lamfe/versaloon-git/(threads)

Thread 1 (2021-04-07):

vsgui compile fix and general questions

bm16ton, 2021-04-07:
to get vsgui to comple needed,

--- /media/maddocks/usb3tb/stm32-std-periph-drivers_porting-tools/versaloon-git/vsgui/hexeditor.pas	2021-04-07 08:28:23.160413990 -0400
+++ /media/maddocks/usb3tb/versaloon-newgui/vsgui/hexeditor.pas	2021-03-15 06:45:00.427950466 -0400
@@ -1048,7 +1048,7 @@
     end;

     try
-      if not FileExistsUtf8(SaveAsFileName) then
+      if not FileExists(SaveAsFileName) then
       begin
         HandleTmp := FileCreate(Utf8ToAnsi(SaveAsFileName));
         if HandleTmp = NULL then
@@ -1246,7 +1246,7 @@
   FillChar(DataBuff[1], DataByteSize, DefaultData);

   // open file and read
-  if FileExistsUtf8(FileName) then
+  if FileExists(FileName) then
   begin
     ext := LowerCase(ExtractFileExt(FileName));
     CurFileParserIndex := 0;

--- /media/maddocks/usb3tb/stm32-std-periph-drivers_porting-tools/versaloon-git/vsgui/texteditor.pas	2021-04-07 08:28:23.163747404 -0400
+++ /media/maddocks/usb3tb/versaloon-newgui/vsgui/texteditor.pas	2021-03-15 06:45:45.752659720 -0400
@@ -25,7 +25,7 @@
     { private declarations }
   public
     { public declarations }
-  end;
+  end;

 var
   FormTextEditor: TFormTextEditor;
@@ -53,7 +53,7 @@
   tmpStrList: TStringList;
   i: integer;
 begin
-  if not FileExistsUtf8(TextFileName) then
+  if not FileExists(TextFileName) then
   begin
     Beep;
     MessageDlg('Error', TextFileName + ' not exists.', mtError, [mbOK], 0);

--- /media/maddocks/usb3tb/stm32-std-periph-drivers_porting-tools/versaloon-git/vsgui/main.pas	2021-04-07 08:28:23.160413990 -0400
+++ /media/maddocks/usb3tb/versaloon-newgui/vsgui/main.pas	2021-03-15 06:49:50.942092130 -0400
@@ -1712,7 +1712,7 @@
       MessageDlg('Error', 'No File Defined.', mtError, [mbOK], 0);
       exit;
     end;
-    if not FileExistsUtf8(TargetFile[fileidx].filename) then
+    if not FileExists(TargetFile[fileidx].filename) then
     begin
       Beep();
       MessageDlg('Error', '"' + TargetFile[fileidx].filename + '" not exists.',
@@ -2087,8 +2087,8 @@
       (Sender as TDirectoryEdit).Directory + System.DirectorySeparator;
   end;

-  VSProg_Exists  := FileExistsUtf8(dedtVSProg.Directory + VSPROG_STR);
-  OpenOCD_Exists := FileExistsUtf8(dedtOpenOCD.Directory + OPENOCD_STR);
+  VSProg_Exists  := FileExists(dedtVSProg.Directory + VSPROG_STR);
+  OpenOCD_Exists := FileExists(dedtOpenOCD.Directory + OPENOCD_STR);
 end;

 procedure TFormMain.FormActivate(Sender: TObject);
@@ -2252,7 +2252,7 @@
 function TFormMain.VSProg_PrepareToRun(aApplicationName: string): boolean;
 begin
   Result := False;
-  if not FileExistsUtf8(aApplicationName) then
+  if not FileExists(aApplicationName) then
   begin
     exit;
   end;

Still not sure if it works havent tried much but many warnings during compile including missing .o's and deprecated things.

This software is incredible!! The more I look thru it the more I find! So it has usb mass storage option for drag n drop programming, and a scripting language that can be built in, both of which require a ton more storage then my f103s have! Have you trie them? What board did u use if so? I see stm32f4 discovery port but no f4 drivers, where early f4s peripherals compatible with f103 or something missing? I see you can compile the programmer into firmware (for drag and drop?) I assume swd uses same pins as jtag? I see the scripting docs and tried to use those commands (without scripting compiled in, again space) and using similiar but different syntax I forest gumped/guessed my way into some that didnt error out. all of my f4s use 25mhz hse and it doesnt look like the code supports that. Im very curious what this firmware with all bells and whistles turned on can do, for example the usbtoeverything does that control the peripherals on the programmer or target? And again how does this compile for f4? Lots of cod didnt go thru it all yet but dont see f4 clock settings (f4 at 72mhz maybe?) or peripheral drivers etc. Anyway super appreciate you keeping the old source and documenting it! seems like zoobab removed a ton of awesome stuff!

lamfe, 2022-03-08:
Hello, @bm16ton, thanks for fixing problems with `vsgui`. I have personally only used versaloon from the command line, so I didn't notice.
I have found this software by chance while looking for a way to upload program to a Silabs C8051 microcontroller that I bought.
A programmer with the C2 interface was needed to do that. (I found versaloon thanks to it being mentioned [here](http://dangerousprototypes.com/docs/Silicon_Labs_C8051F300_Quick_start))

I have only used the firmware on a Blue pill board with STM32F103 chip. I am sorry, but for other questions I don't know the answer, I have only used this software a few times, and have dug through the code just to fix compilation and things for my use. In the process I have felt the need to document the versaloon's usage better and in more detail, which would benefit not only me, but also others who would find a use for this piece of software.

I am glad you find versaloon interesting and contribute to improve it. I don't plan to dig in the code further or expand it, but at least I'll try to keep the compilation working with newer libraries/compilers.
