lamfe/versaloon-git/dongle/hardware/Connect/Connect.sch

## KiCad design dongle/hardware/Connect/Connect.sch (2012-09-20)

Schematic: Connect.sch

Parts:
P0, P1, P2, P3: CONN_10X2
