lamfe/versaloon-git/dongle/hardware/MiniRelease1/Versaloon.sch

## KiCad design dongle/hardware/MiniRelease1/Versaloon.sch (2012-01-09)

Schematic: Versaloon.sch

Parts:
C0, C1: 100uF
C10, C11, C12, C13: 100nF
C14: 1uF
C15, C16: 20pF
D0: LED_Red
D1: LED_Green
D2: LED_Blue
D80, D81, D82, D83, D84, D85, D86, D87, D88: ZD5.1
D90: 1N5817
F0: 200mA FUSE
F90: 50mA FUSE
P0: USBMINI-B
P90: CONN_10X2
Q90: Si2333DS
R10, R95: 100K
R11: 470
R12, R20: 3.3K
R13, R14: 10K
R18, R19, R90, R91, R94: 1K
R80, R81, R82, R83, R85, R86, R87, R88: 240
R84: 68
SW91: SW_PUSH
U0: SP6203-3.3
U1: STF203-22
U10: STM32-48PIN
X0: 12MHz
