lamfe/versaloon-git/dongle/hardware/NanoRelease2/Versaloon.sch

## KiCad design dongle/hardware/NanoRelease2/Versaloon.sch (2014-09-13)

Schematic: Versaloon.sch

Parts:
C0, C1, C16: 1uF
C10, C11, C12, C13, C14: 100nF
C17: 4.7uF
D0: LED_Red
D1: LED_Green
F0: 200mA FUSE
F90: 50mA FUSE
G0: LOGO
P10: CONN_4X2
P90: CONN_5X2
R0, R1: 22
R2: 1.5K
R10: 100K
R11, R12, R18, R19: 1K
R80, R81, R82, R83, R85, R86, R87, R88: 240
R84: 68
U0: XC6206
U1: STM32F401-64PIN
X0: 12MHz

Notes on the sheet:
Fix
Opt
