lamfe/versaloon-git/dongle/hardware/ProRelease3/Versaloon.sch

## KiCad design dongle/hardware/ProRelease3/Versaloon.sch (2013-07-01, an earlier design)

Schematic: Versaloon.sch

Parts:
C0, C1: 100uF
C10, C11, C12, C13, C17, C18, C19, C20, C21, C60, C62, C63: 100nF
C14: 1uF
C15: 100pF
C23, C24, C25, C26, C27, C28, C32: 1uF/25V
C29, C30, C31: 104/25V
D0: LED_Red
D1: LED_Green
D2: LED_Blue
D20, D21: LED_White
D70, D71, D80, D81, D82, D83, D84, D85, D86, D87, D88: ZD5.1
D72: ZD3.3
D90: 1N5817
F0: 200mA FUSE
F90: 50mA FUSE
G0: LOGO
LCM20: COG_LCM_33P
P0: USBMINI-B
P10: CONN_5
P20: CONN_26X2
P90: CONN_10X2
Q20, Q21: NPN
Q90: Si2333DS
R0, R1, R27, R29: 22
R2: 1.5K
R10, R37, R38, R95: 100K
R11: 470
R12, R13: 3.3K
R14, R20, R21, R22, R28, R30, R32, R33, R41, R92: 10K
R18, R19, R25, R26, R36, R90, R91, R94: 1K
R31: 300
R60, R61, R63, R64, R70, R71, R72, R73, R74, R75, R76, R77: NC
R80, R81, R82, R83, R85, R86, R87, R88: 240
R84: 68
RP20, RP21, RP22, RP23, RP24, RP25, RP26, RP27, RP28, RP29, RP30, RP31: R_PACK4
SP20: BEEPER
SW20, SW91: SW_PUSH
U0: LM1117
U10: STM32-48PIN
U11: STM32-144PIN
U20: PARA_NOR_PSRAM_TSOP
X0: 12MHz
