lamfe/versaloon-git/vsf/hardware/ext/memory/VSFmem.sch

## KiCad design vsf/hardware/ext/memory/VSFmem.sch (2012-09-01, an earlier design)

Schematic: VSFmem.sch

Parts:
C0, C1, C2, C3, C4, C5, C6, C10: 100nF
C8, C9: 100uF
G1: LOGO
P0: TFCARD
P01, P02, P03, P11, P12, P21, P22: CONN_4X2
P1, P2, P20, P30: CONN_30X2
P04: CONN_2
P13: CONN_6X2
R0, R1, R2, R3, R4, R5, R6, R7, R8: 10K
R9: 0
R10, R11, R12, R13, R14, R15, R16: 100K
U0: PARA_NOR_FLASH
U1: PARA_SRAM
U2: PARA_NAND_FLASH
U3: SPI_FLASH
U4: LM1117
