lamfe/versaloon-git/vsf/hardware/core/stm32/pcb/vsf_core.sch

## KiCad design vsf/hardware/core/stm32/pcb/vsf_core.sch (2012-09-15)

Schematic: vsf_core.sch

Parts:
C0, C1: 100uF
C2: 10nF
C3: 10uF
C5, C6: 20pF
C7, C8: 6pF
C10, C11, C12, C13, C14, C15, C16, C17, C18, C19, C20, C21, C22: 100nF
D0: RED
F0: 500mA
G0: LOGO
K0, K1: CONN_3
L1: 10mH
P0: USBMINI-B
P1: CONN_10X2
P10: CONN_2X2
P20, P30: CONN_32X2
R1: 0
R2, R3, R8: 22
R4: 1.5K
R5, R7, R10, R11: 10K
SW0, SW2: SW_PUSH
U0: STM32-144PIN
U1: LM1117-3.3
U2: 74LS138
U10: STM32-100PIN
U11: STM32-64PIN
U12: STM32-48PIN
X0: 8MHz
X1: 32.768kHz
