lamfe/versaloon-git/vsf/hardware/ext/memory/pcb/VSFmem.sch

## KiCad design vsf/hardware/ext/memory/pcb/VSFmem.sch (2012-09-15)

Schematic: VSFmem.sch

Parts:
C0, C1, C2, C3, C4, C5, C6, C7, C10: 100nF
C8, C9: 100uF
G0: LOGO
P0: TFCARD
P01, P02, P03, P11, P12, P21, P22: CONN_4X2
P04: CONN_2
P13: CONN_6X2
P20, P30: CONN_32X2
P23: CONN_5X2
R0, R1, R2, R3, R4, R5, R6, R7, R8, R10: 10K
R9: 0
R20, R21, R22, R23, R24, R25, R26: 100K
U0: PARA_NOR_FLASH
U1: PARA_SRAM_TSOPII
U2: PARA_NAND_FLASH
U3: SPI_FLASH
U4: LM1117
U5: IIC_EEPROM
