lamfe/versaloon-git/src/programmer/interfaces/versaloon/versaloon.c

/***************************************************************************
 *   Copyright (C) 2009 - 2010 by Simon Qian <SimonQian@SimonQian.com>     *
 *                                                                         *
 *   This program is free software; you can redistribute it and/or modify  *
 *   it under the terms of the GNU General Public License as published by  *
 *   the Free Software Foundation; either version 2 of the License, or     *
 *   (at your option) any later version.                                   *
 *                                                                         *
 *   This program is distributed in the hope that it will be useful,       *
 *   but WITHOUT ANY WARRANTY; without even the implied warranty of        *
 *   MERCHANTABILITY or FITNESS FOR A PARTICULAR PURPOSE.  See the         *
 *   GNU General Public License for more details.                          *
 *                                                                         *
 *   You should have received a copy of the GNU General Public License     *
 *   along with this program; if not, write to the                         *
 *   Free Software Foundation, Inc.,                                       *
 *   59 Temple Place - Suite 330, Boston, MA  02111-1307, USA.             *
 ***************************************************************************/
#ifdef HAVE_CONFIG_H
#include "config.h"
#endif

#include <stdlib.h>
#include <time.h>
#include "compiler.h"

#include "versaloon_include.h"
#include "versaloon.h"
#include "versaloon_internal.h"
#include "usbtoxxx/usbtoxxx.h"
#include "usbtoxxx/usbtoxxx_internal.h"

#include "versaloon_libusb.h"

#define VERSALOON_STRING					"versaloon"

VSS_HANDLER(versaloon_support);
VSS_HANDLER(versaloon_help);
const struct vss_cmd_t versaloon_notifier[] =
{
	VSS_CMD(	"support",
				"print support information, format: support/S",
				versaloon_support,
				NULL),
	VSS_CMD(	"S",
				"print support information, format: support/S",
				versaloon_support,
				NULL),
	VSS_CMD(	"help",
				"print help information, format: help/h",
				versaloon_help,
				NULL),
	VSS_CMD(	"h",
				"print help information, format: help/h",
				versaloon_help,
				NULL),
	VSS_CMD_END
};

VSS_HANDLER(versaloon_help)
{
	VSS_CHECK_ARGC(1);
	PRINTF("\
Usage of %s:\n\
  -U,  --usb <PID_VID_EPIN_EPOUT>           set usb VID, PID, EPIN, EPOUT\n\n",
		   VERSALOON_STRING);
	return VSFERR_NONE;
}

VSS_HANDLER(versaloon_support)
{
	VSS_CHECK_ARGC(1);
	PRINTF("\
%s: see http://www.SimonQian.com/en/Versaloon\n", VERSALOON_STRING);
	return VSFERR_NONE;
}

// usbtoxxx transact structure
static struct usbtoxxx_info_t versaloon_usbtoxxx_info =
{
	NULL, NULL, 0, NULL
};







// Interfaces:
// Core
static vsf_err_t versaloon_fini(void *p)
{
	struct interfaces_info_t *t = (struct interfaces_info_t *)p;
	
	if (usbtoxxx_info != NULL)
	{
		usbtoxxx_fini();
		usbtoxxx_info = NULL;
	}
	return t->comm->fini();
}

#define VERSALOON_RETRY_CNT				10
static vsf_err_t versaloon_init(void *p)
{
	struct interfaces_info_t *t = (struct interfaces_info_t *)p;
	uint16_t ret = 0;
	uint8_t retry;
	vsf_err_t err = VSFERR_NONE;
	
	if (t->comm->init())
	{
		return VSFERR_FAIL;
	}
	
	// malloc temporary buffer
	if (!versaloon_usbtoxxx_info.buff_len)
	{
		versaloon_usbtoxxx_info.buff_len = 256;
	}
	versaloon_usbtoxxx_info.buff =
						(uint8_t *)malloc(versaloon_usbtoxxx_info.buff_len);
	if (NULL == versaloon_usbtoxxx_info.buff)
	{
		LOG_ERROR(ERRMSG_NOT_ENOUGH_MEMORY);
		err = VSFERR_NOT_ENOUGH_RESOURCES;
		goto versaloon_init_fail;
	}
	
	sleep_ms(100);
	
	// connect to versaloon
	LOG_PUSH();
	LOG_MUTE();
	// not output error message when connectting
	// 500ms delay when connect
	t->comm->set_timeout(100);
	for (retry = 0; retry < VERSALOON_RETRY_CNT; retry++)
	{
		versaloon_usbtoxxx_info.buff[0] = VERSALOON_GET_INFO;
		ret = versaloon_usbtoxxx_info.buff_len;
		if (!t->comm->transact(versaloon_usbtoxxx_info.buff, 1,
								versaloon_usbtoxxx_info.buff, &ret) &&
			(ret >= 3))
		{
			break;
		}
	}
	LOG_POP();
	t->comm->set_timeout(VERSALOON_TIMEOUT);
	if (VERSALOON_RETRY_CNT == retry)
	{
		LOG_ERROR(ERRMSG_FAILURE_OPERATION, "communicate with versaloon: timeout");
		err = ERRCODE_FAILURE_OPERATION;
		goto versaloon_init_fail;
	}
	
	versaloon_usbtoxxx_info.buff[ret] = 0;
	versaloon_usbtoxxx_info.buff_len =
								GET_LE_U16(&versaloon_usbtoxxx_info.buff[0]);
	LOG_INFO("%s", &versaloon_usbtoxxx_info.buff[2]);
	
	// free temporary buffer
	free(versaloon_usbtoxxx_info.buff);
	versaloon_usbtoxxx_info.buff = NULL;
	
	usbtoxxx_info = &versaloon_usbtoxxx_info;
	usbtoxxx_info->comm = t->comm;
	if (usbtoxxx_init())
	{
		err = VSFERR_FAIL;
		goto versaloon_init_fail;
	}
	// fixes programmer abilities
	if (t != NULL)
	{
		if ((t->support_mask & IFS_CLOCK) &&
			!usbtoxxx_interface_supported(USB_TO_CLKO))
		{
			t->support_mask &= ~IFS_CLOCK;
		}
		if ((t->support_mask & IFS_POLL) &&
			!usbtoxxx_interface_supported(USB_TO_POLL))
		{
			t->support_mask &= ~IFS_POLL;
		}
		if ((t->support_mask & IFS_USART) &&
			!usbtoxxx_interface_supported(USB_TO_USART))
		{
			t->support_mask &= ~IFS_USART;
		}
		if ((t->support_mask & IFS_SPI) &&
			!usbtoxxx_interface_supported(USB_TO_SPI))
		{
			t->support_mask &= ~IFS_SPI;
		}
		if ((t->support_mask & IFS_EBI) &&
			!usbtoxxx_interface_supported(USB_TO_EBI))
		{
			t->support_mask &= ~IFS_EBI;
		}
		if ((t->support_mask & IFS_I2C) &&
			!usbtoxxx_interface_supported(USB_TO_I2C))
		{
			t->support_mask &= ~IFS_I2C;
		}
		if ((t->support_mask & IFS_GPIO) &&
			!usbtoxxx_interface_supported(USB_TO_GPIO))
		{
			t->support_mask &= ~IFS_GPIO;
		}
		if ((t->support_mask & IFS_CAN) &&
			!usbtoxxx_interface_supported(USB_TO_CAN))
		{
			t->support_mask &= ~IFS_CAN;
		}
		if ((t->support_mask & IFS_ADC) &&
			!usbtoxxx_interface_supported(USB_TO_ADC))
		{
			t->support_mask &= ~IFS_ADC;
		}
		if ((t->support_mask & IFS_DAC) &&
			!usbtoxxx_interface_supported(USB_TO_DAC))
		{
			t->support_mask &= ~IFS_DAC;
		}
		if ((t->support_mask & IFS_POWER) &&
			!usbtoxxx_interface_supported(USB_TO_POWER))
		{
			t->support_mask &= ~IFS_POWER;
		}
		if ((t->support_mask & IFS_ISSP) &&
			!usbtoxxx_interface_supported(USB_TO_ISSP))
		{
			t->support_mask &= ~IFS_ISSP;
		}
		if ((t->support_mask & IFS_JTAG_HL) &&
			!usbtoxxx_interface_supported(USB_TO_JTAG_HL))
		{
			t->support_mask &= ~IFS_JTAG_HL;
		}
		if ((t->support_mask & IFS_JTAG_LL) &&
			!usbtoxxx_interface_supported(USB_TO_JTAG_LL))
		{
			t->support_mask &= ~IFS_JTAG_LL;
		}
		if ((t->support_mask & IFS_MSP430_JTAG) &&
			!usbtoxxx_interface_supported(USB_TO_MSP430_JTAG))
		{
			t->support_mask &= ~IFS_MSP430_JTAG;
		}
		if ((t->support_mask & IFS_C2) &&
			!usbtoxxx_interface_supported(USB_TO_C2))
		{
			t->support_mask &= ~IFS_C2;
		}
		if ((t->support_mask & IFS_USART) &&
			!usbtoxxx_interface_supported(USB_TO_USART))
		{
			t->support_mask &= ~IFS_USART;
		}
		if ((t->support_mask & IFS_LPC_ICP) &&
			!usbtoxxx_interface_supported(USB_TO_LPCICP))
		{
			t->support_mask &= ~IFS_LPC_ICP;
		}
		if ((t->support_mask & IFS_SWD) &&
			!usbtoxxx_interface_supported(USB_TO_SWD))
		{
			t->support_mask &= ~IFS_SWD;
		}
		if ((t->support_mask & IFS_SWIM) &&
			!usbtoxxx_interface_supported(USB_TO_SWIM))
		{
			t->support_mask &= ~IFS_SWIM;
		}
		if ((t->support_mask & IFS_JTAG_RAW) &&
			!usbtoxxx_interface_supported(USB_TO_JTAG_RAW))
		{
			t->support_mask &= ~IFS_JTAG_RAW;
		}
		if ((t->support_mask & IFS_BDM) &&
			!usbtoxxx_interface_supported(USB_TO_BDM))
		{
			t->support_mask &= ~IFS_BDM;
		}
		if ((t->support_mask & IFS_DUSI) &&
			!usbtoxxx_interface_supported(USB_TO_DUSI))
		{
			t->support_mask &= ~IFS_DUSI;
		}
		if ((t->support_mask & IFS_MICROWIRE) &&
			!usbtoxxx_interface_supported(USB_TO_MICROWIRE))
		{
			t->support_mask &= ~IFS_MICROWIRE;
		}
		if ((t->support_mask & IFS_PWM) &&
			!usbtoxxx_interface_supported(USB_TO_PWM))
		{
			t->support_mask &= ~IFS_PWM;
		}
	}
	
	return VSFERR_NONE;
versaloon_init_fail:
	versaloon_fini(t);
	return err;
}

static vsf_err_t versaloon_reset(void *p)
{
	REFERENCE_PARAMETER(p);
	return VSFERR_NONE;
}

// Commit
static vsf_err_t versaloon_peripheral_commit(void)
{
	return usbtoxxx_execute_command();
}

// Target Voltage
vsf_err_t versaloon_set_target_voltage(uint8_t index, uint16_t voltage)
{
	REFERENCE_PARAMETER(index);
	
	usbtopwr_init(index);
	usbtopwr_config(index);
	usbtopwr_set(index, voltage);
	usbtopwr_fini(index);
	
	return usbtoxxx_execute_command();
}

vsf_err_t versaloon_get_target_voltage(uint8_t index, uint16_t *voltage)
{
	REFERENCE_PARAMETER(index);
	
	usbtopwr_init(index);
	usbtopwr_config(index);
	usbtopwr_get(index, voltage);
	usbtopwr_fini(index);
	
	return usbtoxxx_execute_command();
}

// POLL
static vsf_err_t versaloon_poll_start(uint16_t retry_cnt, uint16_t interval_us)
{
	return usbtopoll_start(retry_cnt, interval_us);
}
static vsf_err_t versaloon_poll_end(void)
{
	return usbtopoll_end();
}
static vsf_err_t versaloon_poll_checkok(enum poll_check_type_t type, uint16_t offset,
								uint8_t size, uint32_t mask, uint32_t value)
{
	uint8_t equ = 0;
	
	if (POLL_CHECK_EQU == type)
	{
		equ = 1;
	}
	return usbtopoll_checkok(equ, offset, size, mask, value);
}
static vsf_err_t versaloon_poll_checkfail(enum poll_check_type_t type, uint16_t offset,
								uint8_t size, uint32_t mask, uint32_t value)
{
	uint8_t equ = 0;
	
	if (POLL_CHECK_EQU == type)
	{
		equ = 1;
	}
	return usbtopoll_checkfail(equ, offset, size, mask, value);
}
static vsf_err_t versaloon_poll_verifybuff(uint16_t offset, uint16_t size, uint8_t *buff)
{
	return usbtopoll_verifybuff(offset, size, buff);
}

// tick clock
vsf_err_t versaloon_tickclk_init(void)
{
	return VSFERR_NONE;
}

vsf_err_t versaloon_tickclk_fini(void)
{
	return VSFERR_NONE;
}

vsf_err_t versaloon_tickclk_start(void)
{
	return VSFERR_NONE;
}

vsf_err_t versaloon_tickclk_stop(void)
{
	// not supported
	return VSFERR_FAIL;
}

uint32_t versaloon_tickclk_get_count(void)
{
	return (uint32_t)(clock() / (CLOCKS_PER_SEC / 1000));
}

struct interfaces_info_t versaloon_interfaces =
{
	VERSALOON_STRING,
	versaloon_notifier,
	
	&versaloon_usb_comm,
	
	false,
	NULL,
	
	IFS_USART | IFS_SPI | IFS_EBI | IFS_I2C | IFS_GPIO | IFS_POWER | IFS_ISSP |
	IFS_JTAG_LL | IFS_POLL | IFS_JTAG_HL | IFS_SWIM | IFS_JTAG_RAW | IFS_C2 |
	IFS_MSP430_JTAG | IFS_LPC_ICP | IFS_SWD | IFS_BDM | IFS_DUSI |
	IFS_MICROWIRE | IFS_PWM | IFS_ADC | IFS_CLOCK | IFS_NAND,
	
	{	// core
		versaloon_init,
		versaloon_fini,
		versaloon_reset
	},
	{
		// clko
		usbtoclko_init,
		usbtoclko_fini,
		usbtoclko_config,
		usbtoclko_enable,
		usbtoclko_disable,
	},
	{	// tickclk
		versaloon_tickclk_init,
		versaloon_tickclk_fini,
		versaloon_tickclk_start,
		versaloon_tickclk_stop,
		versaloon_tickclk_get_count,
	},
	{	// delay
		usbtodelay_init,
		usbtodelay_delayms,
		usbtodelay_delayus
	},
	{	// gpio
		usbtogpio_init,
		usbtogpio_fini,
		usbtogpio_config_pin,
		usbtogpio_config,
		usbtogpio_set,
		usbtogpio_clear,
		usbtogpio_out,
		usbtogpio_in
	},
	{	// usart
		usbtousart_init,
		usbtousart_fini,
		usbtousart_config,
		usbtousart_send,
		usbtousart_receive,
		usbtousart_status
	},
	{	// spi
		usbtospi_init,
		usbtospi_fini,
		usbtospi_get_ability,
		usbtospi_enable,
		usbtospi_disable,
		usbtospi_config,
		usbtospi_select,
		usbtospi_deselect,
		usbtospi_io
	},
	{
		// nand
		usbtonand_init,
		usbtonand_fini,
		usbtonand_config,
		usbtonand_write_cmd,
		usbtonand_write_addr,
		usbtonand_write_data,
		usbtonand_read_data
	},
	{
		// ebi
		usbtoebi_init,
		usbtoebi_fini,
		usbtoebi_config,
		usbtoebi_isready,
		usbtoebi_read,
		usbtoebi_write
	},
	{	// i2c
		usbtoi2c_init,
		usbtoi2c_fini,
		usbtoi2c_config,
		usbtoi2c_read,
		usbtoi2c_write
	},
	{	// pwm
		usbtopwm_init,
		usbtopwm_fini,
		usbtopwm_config_mode,
		usbtopwm_config_freq,
		usbtopwm_out,
		usbtopwm_in
	},
	{	// microwire
		usbtomicrowire_init,
		usbtomicrowire_fini,
		usbtomicrowire_config,
		usbtomicrowire_transport,
		usbtomicrowire_poll
	},
	{	// target_voltage
		versaloon_get_target_voltage,
		versaloon_set_target_voltage
	},
	{
		// adc
		usbtoadc_init,
		usbtoadc_fini,
		usbtoadc_config,
		usbtoadc_config_channel,
		usbtoadc_calibrate,
		NULL, NULL, NULL,
		usbtoadc_sample
	},
	{	// issp
		usbtoissp_init,
		usbtoissp_fini,
		usbtoissp_enter_program_mode,
		usbtoissp_leave_program_mode,
		usbtoissp_wait_and_poll,
		usbtoissp_vector
	},
	{	// swd
		usbtoswd_init,
		usbtoswd_fini,
		usbtoswd_config,
		usbtoswd_seqout,
		usbtoswd_seqin,
		usbtoswd_transact
	},
	{	// jtag_hl
		usbtojtaghl_init,
		usbtojtaghl_fini,
		usbtojtaghl_config,
		usbtojtaghl_tms,
		usbtojtaghl_runtest,
		usbtojtaghl_ir,
		usbtojtaghl_dr,
		usbtojtaghl_register_callback
	},
	{	// jtag_ll
		usbtojtagll_init,
		usbtojtagll_fini,
		usbtojtagll_config,
		usbtojtagll_tms,
		usbtojtagll_tms_clocks,
		usbtojtagll_scan
	},
	{	// jtag_raw
		usbtojtagraw_init,
		usbtojtagraw_fini,
		usbtojtagraw_config,
		usbtojtagraw_execute
	},
	{	// msp430_jtag
		usbtomsp430jtag_init,
		usbtomsp430jtag_fini,
		usbtomsp430jtag_config,
		usbtomsp430jtag_ir,
		usbtomsp430jtag_dr,
		usbtomsp430jtag_tclk,
		usbtomsp430jtag_tclk_strobe,
		usbtomsp430jtag_reset,
		usbtomsp430jtag_poll
	},
	{	// msp430_sbw
		usbtomsp430sbw_init,
		usbtomsp430sbw_fini,
		usbtomsp430sbw_config,
		usbtomsp430sbw_ir,
		usbtomsp430sbw_dr,
		usbtomsp430sbw_tclk,
		usbtomsp430sbw_tclk_strobe,
		usbtomsp430sbw_reset,
		usbtomsp430sbw_poll
	},
	{	// c2
		usbtoc2_init,
		usbtoc2_fini,
		usbtoc2_writeaddr,
		usbtoc2_readaddr,
		usbtoc2_readdata,
		usbtoc2_writedata
	},
	{	// lpcicp
		usbtolpcicp_init,
		usbtolpcicp_fini,
		usbtolpcicp_enter_program_mode,
		usbtolpcicp_in,
		usbtolpcicp_out,
		usbtolpcicp_poll_ready
	},
	{	// swim
		usbtoswim_init,
		usbtoswim_fini,
		usbtoswim_config,
		usbtoswim_srst,
		usbtoswim_wotf,
		usbtoswim_rotf,
		usbtoswim_sync,
		usbtoswim_enable
	},
	{	// bdm
		usbtobdm_init,
		usbtobdm_fini,
		usbtobdm_sync,
		usbtobdm_transact
	},
	{	// dusi
		usbtodusi_init,
		usbtodusi_fini,
		usbtodusi_config,
		usbtodusi_io
	},
	{	// poll
		versaloon_poll_start,
		versaloon_poll_end,
		versaloon_poll_checkok,
		versaloon_poll_checkfail,
		versaloon_poll_verifybuff
	},
	versaloon_peripheral_commit
};
