lamfe/versaloon-git/(commit log)

2009-05-16 add rollback support to pgbar.c, fix bug when no operation is defined, rollback pgbar when program error in stm32isp.c.
    [vsprog.c]
2009-05-16 use a smaller buffer when receive stm32 flash data.
2009-05-17 stm32isp fix
2009-05-17 stm32isp read page size is 256 bytes.
2009-07-23 1. retry if read LPC900 device id failed
2009-07-23 1. fix command-line options 2. add support to mutiple Versaloons by identifying serial string
    [versaloon.c, vsprog.c]
2009-07-28 1. fix -U option
    [versaloon.c]
2009-09-29 enable -Wextra option and fix warnings
    [vsprog.c]
2009-09-29 add more info when printing version
2009-10-02 retry while fail to read stm32 chip information in stm32isp
2009-10-02 The problem is extra data after sync for stm32isp.c
2009-10-04 1. convert to upper case when parsing parameters of -C 2. roll back to previous implementation of stm32isp.c, previous error lies in the CDC tool
2009-10-09 Add CDC firmware for Mini-Version, under dongle/firmware/Projects/CDC. Add files for Versaloon firmware, project files are not ready. Add driver files in dongle/driver. Add udisk image in dongle/udis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
2009-10-09 remove unnecessary files, upload versaloon firmware(but not recommended currently), fix readme about versaloon firmware.
    [app_cfg.h]
2009-10-09 Update driver information under Linux, in file dongle/firmware/readme.
2009-10-11 1. enable myString.c when using Codesourcery G++ Lite for STM32. 2. show image sections and size after compile firmware. 3. add vsprog to program flash of STM32
2009-10-11 fix _estack definitation in stm32.ld file
2009-10-16 1. fix app_log.h 2. add SWJ interface 3. USB_TO_XXX return value tweak 4. Display message and exit if specified interface not supported in USB_TO_XXX 5. VSLLink tweak 6. add SWJ support to VSLLink dr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
    [prog_interface.h]
2009-10-16 fix JTAG_HL bug in firmware when operating DR in daisy chain mode
2009-10-16 JTAG_TAP.c fix for daisy chain operation
2009-10-17 1. add uint64 and int64 in app_type.h 2. add JTAG daisy chain support 3. add SWJ support 4. remove unnecessary static in c8051f_jtag.c 5. add comisp_internal.h
2009-10-18 1. add JTAG daisy chain support(-J option) 2. remove USB_TO_JTAGHL(original -J option) 3. callback support for JTAG_HL
2009-10-18 1. implement JTAG write send callback and receive callback 2. add JTAG daisy chain support to AVR and C8051F.
2009-10-19 1. add code for STM32 JTAG/SWJ programming
2009-10-19 1. display flash size only if SRAM size is invalid in STM32
2009-10-19 1. implement STM32 JTAG/SWJ flash read/verify. 2. adi/cmd3 fix
2009-10-19 use macro: STM32_FLASH_START_ADDRESS
2009-10-19 1. update ASM code used in STM32 JTAG/SWJ
2009-10-20 STM32 support for Flash read and write is OK
2009-10-20 display STM32 MCU_ID and flash/sram size
2009-10-20 add -b option for STM32 JTAG buffer_size(used to get a max speed, can ignore)
2009-10-20 check buffer_size in STM32 support, it should be aligned to 4
2009-10-23 SPI more robust in firmware
2009-10-24 SWJ OK on STM32
2009-11-05 fix buffer size of CDC implementation in firmware
    [app_cfg.h]
2009-11-07 add support to AVR fuse and lock
2009-11-10 add experimental support to fuse and lock
2009-11-10 fuse and lock support, implemented on atmega128, for test now
2009-11-10 destroy auto-created components in VSGUI fuse and lock window
2009-11-10 read fuse and lock from target in VSGUI
2009-11-10 remove unsupported lock and fuse in VSGUI
2009-11-10 fuse and lock not editable in value in VSGUI
2009-11-11 1. use checkbox for fuse and lock settings
2009-11-11 fix a bug when checking warning in VSGUI fuse and lock support
2009-11-12 fix bug in parameter processing in VSGUI when reading lock or fuse
2009-11-12 Add Calibration support
2009-11-12 fix hint message for AutoDetect button in VSGUI
2009-11-12 1. set OK button as default 2. mask the readout value
2009-11-12 close window on ESC key in VSGUI
2009-11-14 add general setting for fuse/lock
2009-11-14 bug fix: OK and Cancel buttons are not centered at the first time
2009-11-14 add bytelen to define size of fuse and lock setting in edit mode
2009-11-14 show hint on ComboBox and Edit for fuse/lock/sig setting in VSGUI
2009-11-14 disable fuse/lock/calibration of AVR by default
2009-11-15 Firmware update: driver PWR_CTRL by push-pull output for Pro Hardware
2009-11-15 revert to 169: use push-pull(3.3V level) to control power out will fail if output 5V
2009-11-17 use common probe_chip is XML configuration file parsed OK
2009-11-22 display only the necessary bytes for AVR fuse/calibration
2009-11-25 1. bug fix 2. implement eeprom support for avr8
    [vsprog.c]
2009-11-27 remove auto detect in CortexM3-STM32 in VSGUI
2009-11-28 fix a bug when displaying target voltage
    [versaloon.c]
2009-11-29 fix makefile to use timer.h
2009-12-01 fix compile error under ubuntu
    [file_parser.c]
2009-12-02 continue to check next target if current is not available in target.c
2009-12-02 fixs for linux version
    [vsprog.c]
2009-12-02 fix bug in windows, add FILE_SEPARATOR
    [vsprog.c]
2009-12-02 find current directory if all the other directories are not found for configure file
2009-12-08 cleanup PowerOut functions
2009-12-09 1. usb USB_TO_JTAGHL by default, which support to be polled in USB_TO_POLL 2. add callback support in Versaloon driver
2009-12-10 add USB_TO_JTAGHL, remove vsllink driver
2009-12-10 avoid crash in versaloon_swj_commit
    [versaloon.c]
2009-12-12 read to file operation is usable, tested on STM32_JTAG
2009-12-12 STM32_JTAG/SWD fix for page size
    [file_parser.c]
2009-12-12 fix BUG when handle AVR flash after 0x10000
    [file_parser.c]
2009-12-12 firmware update: set SPI frequency after initialize
2009-12-12 Add power setting in VSGUI
2009-12-14 fix a bug when write content to file in vsprog
    [file_parser.c]
2009-12-14 check the validity of the target in xml config file, ignore if not valid(match current page)
2009-12-14 find for target name ALL if current target if not available
2009-12-15 ignore case when parsing file ext
2009-12-21 add STM32 page
2009-12-21 recover all AVR8 program mode, although HVPP and HVSP are not currently supported
2009-12-22 STM32 fix for ISP operation
2009-12-24 STM32 StdPer Lib Update
2009-12-29 add SWIM interface driver
2009-12-30 STM32 update
2009-12-31 makefile update to for stm32_internal.h
2010-01-01 code cleanup, simplify programming operation, STM8 and STM32 is working, others will follow soon
2010-01-04 STM8 eeprom/fuse support, use 64-bit
2010-01-05 fix to 64-bit operations
    [versaloon.c]
2010-01-05 fix error in printf in target.c
2010-01-05 use inttypes.h for 64-bit printf
2010-01-12 1. C8051F JTAG fix, error in datasheet 2. AVR JTAG read ID fix
    [app_cfg.h]
2010-01-14 switch to IAR EWARM 5.41 KS
2010-01-22 Add HV(High Voltage) interface required by AVR8_HVPP and AVR8_HVSP
2010-01-24 Add MiniRelease1 schematics
2010-03-04 BUG fix in hex parser, add break in case
2010-03-10 VSGUI update, add SaveAs button in hexeditor
2010-03-10 printf speed after programming/verifying/reading target date.
2010-03-10 1. print more information when cortex-m3 fails to initialize 2. ADIv5 clean up
2010-03-11 STM32 fix, enable reset after erase, need test for ISP/JTAG/SWD.
2010-03-19 firmware update for I2C test program. patch will be committed when test is OK to remove features for test.
2010-03-21 press ESC to exit texteditor in VSGUI
2010-03-26 fix printf format error for GCC
2010-03-31 remove unnecessary files: lib help file for STM32F10x_Lib Interface/I2C.* files Projects/CDC
2010-04-01 change I2C to IIC in USB_TO_XXX
2010-05-13 clean up of script support. rewind input script file first, print error message if command not exists.
2010-05-14 fix timeout bug, need test
    [versaloon.c]
2010-05-17 stm32isp cleanup, change stm32isp_sycn to stm32isp_sync
2010-05-28 at91sam3 update and clean up. other BUG to be fixed: EEFC will fail in some cases.
    [vsprog.c]
2010-05-29 add USB_TO_POLL_CHECKFAIL to check for failure status
    [versaloon.c]
2010-06-03 add support to STM32 value-line devices
2010-06-06 BUG fix for USB_TO_SPI, fail to set spi configuration
2010-06-09 add kicad files for Versaloon-MiniRelease1 hardware
    [Versaloon.brd, Versaloon.sch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]
2010-06-13 1. KiCAD library udpate 2. add generic MACROs for handlers
2010-06-25 STM8 support update, prepare for adding new devices
2010-07-02 1. flashloader for stm8 is working, but it's slower. 2. USB_TO_POLL: return immediately on failure 3. add PRI feature to SWIM_CSR
    [versaloon.c]
2010-07-08 1. update libusb0.dll to the latest version 2. filter out repeating dongles while display connected dongles
2010-07-08 update libusb-win32 driver to 1.2.0.0
2010-07-12 1. strengthen USB_TO_POLL, firmware update needed, need more test 2. implement avrxmega erase/write operation, though slow enough
    [versaloon.c]
2010-07-13 1. fix compile error for GCC 2. move fileparser to tools 3. add strparser which is planned to be used to parse target value(fuse/lock/calibration....)
    [vsprog.c]
2010-07-14 ****unstable version**** implement strparser layer to process target defined in command line
    [vsprog.c]
2010-07-15 fix overflow bug in avr8_jtag.c when reading lock bit and calibration byte avr8 is working
2010-07-15 1. fix bug in reading lpc900 chip_id 2. fix bug in verifying lpc900 flash STM32/LPC1000/AT91SAM3/STM8/C8051F/AVR/LPC900 are working.
2010-07-16 STM8 fuse update, use multi-section format FUSE support for STM8 in VSGUI is broken, will be fixed in the next patch
2010-07-17 1. add bytelen section for calibration settings 2. BUG fix: VSGUI doesn't update fuse setting
2010-07-20 VSGUI update, validate cancel operation if cancel button in parameditor clicked
2010-07-20 reset usb device before operation under non-windows environment
2010-07-22 disable flash programming interrupts of lm3s when enter_program_mode
2010-07-28 1. remove test functions in IIC driver 2. add scripts framework and implement more programmer_scripts
2010-07-30 BUF fix in firmware ISSP.c: not enough delay on PowerOn, fail if the signal is noisy.
2010-07-30 1. strparser fix, increase str if compare OK 2. target support code cleanup, remove unused include files 3. implement script framework, move codes to scripts. -V option is NOT usable in this version.
    [versaloon.c, vsprog.c]
2010-07-30 add programmer_assert to make sure programmer is well initialized. -V option is usable now without collision.
    [vsprog.c]
2010-07-30 bug fix and tweaks for shell mode, looks better now
    [vsprog.c]
2010-07-30 fix error under MinGW, const string should first be copied into a buffer, than pass to misc_run_script
    [vsprog.c]
2010-07-31 use misc_script framework in programmer module
2010-08-01 1. remove call cur_programmer->fini in comm_close_usbtocomm, cur_programmer->fini is ONLY called in free_all, and programmer_assert. 2. usb_param.valid is only set if VID/PID is defined.
2010-08-01 set SWD_Delay in VSLLink.c to be fit to the latest SWD driver in firmware
2010-08-04 1. add a USB vendor request to disable usart in cdc_device. 2. try detaching kernel driver under Linux
2010-08-05 1. -q is no-argument 2. fix: in scripts.c unwanted return will appended even though '@' is defined before command
    [vsprog.c]
2010-08-07 BUG fix: program_info.chip_type and program_info.chip_name will be corrupt in shell mode.
    [vsprog.c]
2010-08-13 add LPCARM_ISP support and clean up comm driver, need test
2010-08-17 fix a proto in Linux driver for com port, should be TCIFLUSH, not TCLIFLUSH
2010-08-20 fix a bug when printing 32bit data in svf_parser.c
2010-08-20 add line number when printing current command in svf_player in debug mode
2010-08-21 Reset double speed in LEAVE_PROGRAM_MODE_FUNCNAME of stm8. It seems this register is reset ONLY after power on reset.
2010-08-23 1. Move SWIM macros as SYNCSW functions, which will be used in BDM support 2. simply stm8 exit operation, which maybe more stable 3. print the times of the loop count when error, if running one scrip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
    [vsprog.c]
2010-08-28 1. remove DMA init and fini operation to MACROs in config file 2. use DMA operation for SYNCSWPWM output
2010-08-29 add kicad files for Nano release1 hardware
    [Versaloon.brd, Versaloon.sch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]
2010-08-29 1. use CC1 instead of Update as DMA trigger event, avoid spikes
2010-08-29 1. add remap function, remove mass-product functions 2. s12x fix, need test 3. bug fix in memlist.c, error when insert before the list
2010-08-30 original USB driver is removed, USB driver should be added to application directory
2010-09-01 implement generic delay timer, remove original non-portable code.
2010-09-03 1. add SampleVtarget in HW.c, useful if command require get the Vtarget immediately 2. BDM cleanup, expand usage
2010-09-03 bug fix in SampleVtarget.
2010-09-09 1. use macros to define cycles in BDM.c 2. get current target power when determine whether to power the target
2010-09-15 remove libusb driver, please use inf-wizard in the latest libusb-win32.
2010-10-02 adjust resistor parameter in VersaloonNano hardware
    [Versaloon.sch]
2010-10-15 add ADC port defines in NanoRelease1.h, this pin is used to pull the Key pin
2010-10-18 stm32 minor fix, halt target while downloading flash loader
2010-10-27 1. use stdbool.h 2. change flash_page_size of stm32 to 1024/2048 3. fix stm32isp.c for change of page size 4. add -e option and e script to support erase_on_demand feature
    [vsprog.c]
2010-10-30 1. fix page size for connectivity line of stm32f 2. initialize page size and page num in stm32 isp
2010-12-12 unstable and incompatible. generalize interfaces structure
    [interfaces.c, interfaces.h, versaloon.c]
2010-12-12 add first Schematics for pro hardware for preview
    [Pro.sch]
2010-12-12 Not Pro hardware, but Handy platform
    [Handy.sch]
2010-12-12 Update KiCAD library for Handy hardware
2010-12-12 generalize spi api
2010-12-12 1. fatal error, want_ret SHOULD NOT be removed, roll back 2. add callback for jtaghl in firmware
    [interfaces.c, interfaces.h]
2010-12-13 tweak for handy schematic preview
    [Handy.sch]
2010-12-13 add thermistor, voltage check on vcc and tvcc
    [Handy.sch]
2010-12-18 1. Handy hardware update 2. firmware update, remove poll api
    [Handy.sch]
2010-12-19 fix compile error when configure USB_TO_XXX_EN in app_cfg.h, Thanks to bingo
    [interfaces.c, interfaces.h]
2010-12-23 fix BUG in SPI interface driver in firmware.
2010-12-26 VersaloonHandy hardware update: 1. support USB_FS_OTG 2. use USBLC6_4 3. use NUF8401MNT4G 4. use MIC2826 5. 16 pin interface
    [Handy.sch]
2010-12-30 VersaloonHandy schematic update: 1. add PROGKEY 2. use 16PIN output instead of 18PIN
    [Handy.sch]
2011-01-01 hardware update: 1. use 16pin header for VersaloonHandy 2. add VersaloonMiniRelease2 schematics, available in 6 months according to the schedule after VersaloonHandy 3. library update
    [Handy.sch, Versaloon.sch]
2011-01-03 hardware update: add mode led(7 colors) to VersaloonMiniRelease2
    [Versaloon.sch]
2011-01-08 STLink is ready on the latest framework
2011-01-08 USBDM is working under the latest framework
2011-01-09 add stm8s-discovery and stm32vl-discovery support.
2011-01-10 for stm32 smaller than 128K, there exists exactly 128K flash.
2011-01-10 fix project files, simpler to config
    [app_cfg.h]
2011-01-10 fix typo in st-discovery.ld and board_defs.mk
2011-01-28 add support to option bytes of STM32.
2011-01-28 reset after programming stm32 flash
2011-01-28 enable poll thread in vsgui, prepare for future features
2011-01-29 check interfaces supported by current programmer
2011-01-29 optimize fuse operations for stm32
2011-01-29 loop until poll thread release the handle in VSGUI
2011-02-02 MiniRelease2 PCB, not tested. Want STM32F205_64Pin.
    [Versaloon.brd, Versaloon.sch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]
2011-02-02 MiniRelease2 hardware update, compatible with STM32F105
    [Versaloon.brd, Versaloon.sch]
2011-02-02 Update Old hardware for new library
    [Versaloon.brd, Versaloon.sch]
2011-02-03 MiniRelease2 PCB post process, ready to be sent to factory
    [Versaloon.brd, Versaloon.sch]
2011-02-03 fix wrong footprint for USB-B in Release2
    [Versaloon.brd, Versaloon.sch]
2011-02-03 remove reference drawings in MiniRelease2
    [Versaloon.brd]
2011-02-03 remove drill files for PCB, can be automatically generated
    [Versaloon.brd]
2011-02-03 update KiCAD library
2011-02-05 add function support to script, need test
    [Versaloon.brd]
2011-02-07 not call target_leave_progmode if fail to enter_program_mode.
    [Versaloon.brd]
2011-02-07 add a beeper to Mini2
    [Versaloon.brd, Versaloon.sch]
2011-02-07 use wider route for power lines
    [Versaloon.brd]
2011-02-08 update LQFP48 and SOT89 footprint
    [Versaloon.brd]
2011-02-11 update configuration files for ST-Discovery board
2011-02-11 Change original MiniRelease2 to ProRelease1
    [Versaloon.brd, Versaloon.sch]
2011-02-17 for print_usb_devices and find_usb_device, use -1 as index to indicate not support
2011-02-17 usb_param.valid is set to 1 only after VID/PID/EPIN/EPOUT are all set
2011-02-23 add usbtodusi driver
2011-02-24 1. fix FLASH SIZE bug of STM32 VL series 2. add STM32 XL support, but not ready now
2011-02-25 fix typo in src/app_cfg.h
    [app_cfg.h]
2011-02-27 support to STM32 with 1M bytes flash
2011-03-03 PCB fixes for Pro1
    [Versaloon.brd]
2011-03-06 fix MIC2826 robust issue
    [mic2826.c]
2011-03-07 remove idle parameter in config function of pwm interface
2011-03-08 pwm_out fixes, now working
    [interfaces.c, interfaces.h, versaloon.c]
2011-03-08 fix compile error under Linux introduced by mic2826 support
    [mic2826.c]
2011-03-08 fix pwm_out BUG when set rate to 0xFFFF.
2011-03-11 Modify to use PB1/SRST as VL Reset in stm32vl-discovery support
2011-03-11 add reset-after-write feature to fuse of STM32 fuse setting will not be valid until reset
2011-03-11 no need to reload flash-loader of STM32 is flash size to program is 0
2011-03-11 support stm32 with flash_sram_reg = 0xFFFFFFFF
2011-03-11 if fuse write is not defined but fuse erase is defined, add a fuse write operation with default non-lock fuse value. So that -oe parameter will not lock STM32
2011-03-16 USBDM fixes for latest change in GPIO driver
2011-03-20 add mal framework, drivers will be implemented later
2011-03-22 add first spi dataflash support, test version
2011-03-24 1. change page size of df25xx 2. fix error when passing NULL to spi.io
2011-03-27 hardware update for ProRelease1, note: still not the final version. We need more confirmation.
    [Versaloon.brd, Versaloon.sch]
2011-03-27 tweak silk of C18 in ProRelease1 hardware
    [Versaloon.brd]
2011-03-27 add virtual programmer command line parameter. After implemented, you can use for example "-lstm32 -iSPI0:0;CS0:1" to program a dataflash connected to a STM32 chip.
2011-03-31 add Zener Diodes for over-voltage protect in VersaloonPro hardware
    [Versaloon.brd, Versaloon.sch]
2011-04-01 add framework for sd_spi driver, not implemented now
2011-04-02 tweak for VersaloonPro hardware, the 2nd version hardware will be sent to factory soon.
    [Versaloon.brd]
2011-04-05 fix help message of -I and -O option
    [vsprog.c]
2011-04-06 fix iic.read and iic.read_buff8 for false number of parameters
    [interfaces.c]
2011-04-08 move dal to vsf, which is Versaloon Software Framework
2011-04-11 add c header to interfaces.c to avoid compile warnings
    [interfaces.c]
2011-04-11 use odd PC when running flash_loader in stm32
2011-04-15 add config_interface support so that driver can support multiple targets
2011-04-19 fix a bug in MEMLIST_Insert, when insert into the list
2011-04-21 add stm32f2 support, not optimized
2011-04-21 update makefile for stm32f2
2011-04-22 optimize for stm32, use tick tock operation
2011-04-22 add other functions for df25xx driver, need test
2011-04-24 implement generic(CM0 instruction-based) flash loader for both STM32 and STM32F2, need further test
2011-04-24 setup virtual programmer framework
2011-04-24 fix makefile for the previous change
    [interfaces.h]
2011-04-24 use pc offset instead of if-else structure in stm32 flash loader
2011-04-24 remove WNP feature of stm32 flash
2011-04-25 increase timeout for stm32 flash loader, flash mass erase of stm32f2 will take very long time
2011-04-26 update df25xx driver
2011-05-06 add code for generic usb device stack for vsf(Versaloon Software Framework), first implementation, not tested
2011-05-07 device structure should be the parameter for drv->init in VSF_USBD
2011-05-11 add common interfaces for STM32
2011-05-17 add framework of vsfusbd_HID
2011-05-22 add gpio_rts_enable and gpio_dtr_enable in vsfusbd_CDC_param_t to config RTS and DTR pin
2011-05-22 bug fix when handle OUT page of EP0 in data stage
2011-05-22 poll usart rx data in interrupt in CDC protocol
2011-05-22 check EP_Cfg_Ptr first in STM32_USBD driver
2011-05-23 add framework for MSC_BOT driver
2011-05-24 implement MSC transaction framework
2011-05-25 fix toggle error of VSFUSBD
    [interfaces.c, interfaces.h]
2011-05-25 In usbapi.c 1. no need to reset usb 2. no need to detach from kernel driver 3. no need to set configuration
2011-06-01 use 32-bit for kHz in SPI, DUSI, JTAG APIs, so that 65M+ frequency can be supported
2011-06-01 update spi.config script to support 32-bit frequency
2011-06-03 fix compile error for STM32VL-Discovery and STM8S-Discovery
2011-06-04 update sd_spi driver, initialization is OK
2011-06-08 add nrf24l01 driver
2011-06-08 add more parameter check in nrf24l01 driver
2011-06-09 bug fix for STM32 with 2k flash page size
2011-06-16 fix error in board_defs.mk
2011-06-23 add spi, timer, eint files, not all implemented
2011-07-23 update VSF, there is some problem when compiling using GCC, but IAR is OK
    [app_cfg.h, app_interfaces.c, app_interfaces.h, interfaces.c, interfaces.h]
2011-07-23 sample tvcc after set
2011-08-02 add ebi support, add cfi_nor support, improve mal driver
2011-08-15 MSC firmware update for LED MACROs
2011-08-15 sd_spi bug fix, tested working on stm32
2011-08-15 remove USART interrupt code in MSC application
2011-08-20 add reset call to interfaces
    [interfaces.c, interfaces.h]
2011-09-08 mal update so that it can be available for small ram device
2011-09-08 1. add internal flash drivers 2. update cfi.c for the ram size optimization
2011-09-26 remove timer module, use <time.h> instead
2011-09-27 remove RESULT, ERROR_OK, ERROR_FAIL, use vsf_err.h instead.
    [app_interfaces.c, app_interfaces.h, interfaces.c, interfaces.h]
2011-09-28 remove some of original error codes, use vsf_err.h instead
    [versaloon.c, vsprog.c]
2011-09-29 update windows driver for versaloon
2011-10-14 enable both USER pin as input pull-up or input pull-down
2011-10-25 stm8s-discovery board fix makefile fix so that out file will be different according to different configuration
2011-10-27 add stm32l-discovery support
2011-10-27 fix AFIO remap code for stm32
2011-11-14 make alternate_settin in USB device stack private variable
2011-11-14 bug fix in usb_protocol_CDC.c, CDC device should only support 2 interfaces, not 3
2011-11-24 divide pwm.config to pwm.config_mode and pwm.config_freq
2011-12-05 improve interface_init, will not assign cur_interface if initialization is failed
    [interfaces.c]
2011-12-05 add stm32f4-discovery support, IMP: TMS and TCK are not reversed, STM32F4 support is under development
2011-12-06 add stm32f4 support
2011-12-06 fix bug in interface_jtag_ir, invalid use of SYS_TO_LE_U32
    [interfaces.c]
2011-12-07 1. add jtag.reset script 2. simplify using INTERFACE_ASSERT
    [interfaces.c]
2011-12-07 use hw_cfg_st_link.h for all st_link compatible devices
2011-12-10 add support to stm32l, ONLY flash operation is implemented
2011-12-10 add stm32f4_notifier
2011-12-14 interfaces.c fixes for spi and gpio
    [interfaces.c]
2011-12-15 Emu_SPI can support all SPI modes
2011-12-19 fix bug in board_defs.mk, one endif missing
2011-12-19 OOps, another 2 missing endif in board_defs.mk
2011-12-21 remove USB interrupt, use poll mode
2011-12-21 add device->drv->poll(); to vsfusbd_ep_in and vsfusbd_ep_out poll loop
2011-12-21 SYNCSWPWM can now work in both UPDATE DMA and COMPARE DMA.
2011-12-21 add back USART interrupt for Versaloon firmware
2011-12-25 add IFS_XXX_EN checker to drivers
2011-12-25 STM32_EBI.c fixes to check IFS_EBI_EN
2011-12-25 check DAL_XXX_EN in peripheral drivers
2011-12-26 include dal.h in peripheral drivers
2012-01-01 fix compile problem under IAR
    [app_interfaces.h]
2012-01-02 Kicad library update, new board coming soon.
2012-01-09 hardware update for the latest Kicad
    [Versaloon.sch]
2012-01-09 extend printf and scanf for firmware, compiler can detect it automatically
2012-01-15 add SYS_CFG_LARGE_MEMORY to config the algorithm of memory usage, fix a bug in MEMLIST_VerifyBuff
    [app_cfg.h]
2012-01-16 fix swd driver, work in embedded vsprog
2012-01-16 one main reason will cause embedded vsprog to HARD_FAULT: In original vsprog, all data is in RAM, so it's always safe to modify them, but in embedded vsprog, some data is in flash. Trying to write da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
2012-01-17 led progress bar is working on VersaloonPro
2012-01-17 add ShellonVersaloon driver
2012-01-19 1. fix some compile warnings on old GCC 2. add embedded vsprog to makefile
    [vsprog.c]
2012-01-20 same fix to embedded vsprog.c
    [vsprog.c]
2012-01-20 enhance vss-help scripts, print subcmd if valid
2012-01-22 add MSConVersaloon device to Versaloon, how simple will it be to add a new USB device on the super VSF_USBD stack
2012-01-27 enhance GPIO and SPI module
2012-01-27 check IFS_DUMMY_PORT in sd_spi driver
2012-01-27 sd driver is working
2012-01-28 sd_spi driver update, now full unblock operation
2012-01-29 add SDIO driver, sdio command processor is OK
2012-01-29 STM32 SDIO vital BUG: HW Flow Control not usable, any other way to unblock code?
2012-02-06 modify IIC pin out, changed to SCL = TMS, SDA = TDO. Because these 2 PINs has on-board pull-up.
2012-02-06 change LED name, add LED_POWER, LED_STATE
2012-02-06 BIT_REVERSE_U8 should be called in LED_ARRAY_SET
2012-02-08 fix vital BUG in STM32 USB library, _ClearEP_CTR_RX and _ClearEP_CTR_TX will accidentally clear EP_CTR_TX or EP_CTR_RX
2012-02-09 Add ProRelease2 hardware
    [Versaloon.brd, Versaloon.sch]
2012-02-09 ProRelease2 update R11 should be 470 Ohm
    [Versaloon.sch]
2012-02-10 add scripts for 7-color led
2012-02-13 ONLY set endpoint in STALL mode when error, or USB transaction will be broken if USB processor is not called in time.
2012-02-21 print auto-detect message ONLY when auto-detect should run
2012-02-21 print result message while verifying target area with AREA_ATTR_V feature
2012-02-25 add time script used to display MS passed after power-up
2012-02-28 fix atomic operation to stm32_tickclk_get_count
2012-02-28 add a endpoint address manager to STM32_USBD
2012-03-03 Update USB PID in 60-versaloon.rules
2012-03-09 add codelite project for versaloon firmware
    [Gdb_Server.cfg, Program_flash.cfg]
2012-03-17 add geber files and drill files for MiniRelease1 and ProRelease2 hardwares
    [Versaloon-Component.gtl, Versaloon-Copper.gbl, Versaloon-GND_Layer.gbr, Versaloon-Mask_Back.gbs, Versaloon-Mask_Front.gts, Versaloon-PCB_Edges.gbr, Versaloon-SilkS_Back.gbo, Versaloon-SilkS_Front.gto]
2012-03-19 Update KiCAD library for versaloon hardware
2012-03-22 update ProRelease2 hardware
    [Versaloon-Component.gtl, Versaloon-Copper.gbl, Versaloon-GND_Layer.gbr, Versaloon-Mask_Back.gbs, Versaloon-Mask_Front.gts, Versaloon-PCB_Edges.gbr, Versaloon-SilkS_Back.gbo, Versaloon-SilkS_Front.gto]
2012-03-24 add stm32 vsf_core board
    [vsf_core.brd, vsf_core.sch]
2012-03-24 add CLK_OUT and CLK_IN to stm32 vsf_core board
    [vsf_core.brd, vsf_core.sch]
2012-04-04 add STM32F0-DISCOVERY support
2012-04-08 add support to STM32 with 1MB flash
2012-04-15 vsf_core stm32 hardware update
    [vsf_core.brd, vsf_core.sch]
2012-04-16 add VSFCore stm32 board firmware
2012-04-22 add memory board for vsf platform
    [memory.brd, memory.sch]
2012-05-13 1. add ADC3 support for STM32 2. and sample block function to do ADC sample
2012-05-13 add virtual ADC interface for VSFcore stm32 board
2012-05-14 add icf file for VSFcore stm32 board
2012-06-22 add STM32F4_Discovery release firmware
2012-06-26 vsfusbd: support class request with device recipient
2012-06-27 add app_interface adc in makefile of versaloon firmware
2012-07-03 vsfusbd and usbd driver update for compatibility
2012-07-05 add VSFUSBD_SETUP_NULL to indicate end of setup filter array
2012-07-06 nuc100 configuration update, remove jtag interface, not supported by current nuc100
2012-07-11 fix df25xx_drv and nrf24l01_drv module, should configure spi to master mode
2012-07-19 fix a bug in STM32_USBD.c: when compiler highest optimized, there will be issues in STM32 USB SIE
2012-08-01 simplify stm32 vsf_core board
    [vsf_core.brd, vsf_core.sch]
2012-08-02 update stm32 vsf_core board
    [vsf_core.brd]
2012-08-03 add geber files for stm32 vsf_core board
    [vsf_core-Back.gbl, vsf_core-Front.gtl, vsf_core-InnerBack.gbr, vsf_core-InnerFront.gbr, vsf_core-Mask_Back.gbs, vsf_core-Mask_Front.gts, vsf_core-PCB_Edges.gbr, vsf_core-SilkS_Back.gbo]
2012-08-08 add a funsel for stm32 vsf board, select USB_DM or PWM_C4
    [vsf_core-Back.gbl, vsf_core-Front.gtl, vsf_core-InnerBack.gbr, vsf_core-InnerFront.gbr, vsf_core-Mask_Back.gbs, vsf_core-Mask_Front.gts, vsf_core-PCB_Edges.gbr, vsf_core-SilkS_Back.gbo]
2012-08-09 make I2S interface in stm32 vsf_core board full-duplex
    [vsf_core-Back.gbl, vsf_core-Front.gtl, vsf_core-InnerBack.gbr, vsf_core-InnerFront.gbr, vsf_core-Mask_Back.gbs, vsf_core-Mask_Front.gts, vsf_core-PCB_Edges.gbr, vsf_core-SilkS_Back.gbo]
2012-08-09 add a funsel for stm32 vsf board, select USB_DP or PWM_TRG
    [vsf_core-Back.gbl, vsf_core-Front.gtl, vsf_core-InnerBack.gbr, vsf_core-InnerFront.gbr, vsf_core-Mask_Back.gbs, vsf_core-Mask_Front.gts, vsf_core-PCB_Edges.gbr, vsf_core-SilkS_Back.gbo]
2012-08-17 fix hardware configuration for VSFCore_stm32 board
2012-08-19 bug fixes for the last patch
    [interfaces.c, vsprog.c]
2012-08-21 create bsp for VSFCore_stm32 board
    [vsf_core-Back.gbl, vsf_core-Front.gtl, vsf_core-InnerBack.gbr, vsf_core-InnerFront.gbr, vsf_core-Mask_Back.gbs, vsf_core-Mask_Front.gts, vsf_core-PCB_Edges.gbr, vsf_core-SilkS_Back.gbo]
2012-08-31 VSF hardware update
    [VSFmem-Back.gbl, VSFmem-Front.gtl, VSFmem-InnerBack.gbr, VSFmem-InnerFront.gbr, VSFmem-Mask_Back.gbs, VSFmem-Mask_Front.gts, VSFmem-PCB_Edges.gbr, VSFmem-SilkS_Back.gbo]
2012-08-31 enable spi.select and spi.deselect
2012-09-01 geber file update
    [VSFmem-Back.gbl, VSFmem-Front.gtl, VSFmem-InnerBack.gbr, VSFmem-InnerFront.gbr, VSFmem-Mask_Back.gbs, VSFmem-Mask_Front.gts, VSFmem-PCB_Edges.gbr, VSFmem-SilkS_Back.gbo]
2012-09-01 VSFmem update
    [VSFmem-Back.gbl, VSFmem-Front.gtl, VSFmem-InnerBack.gbr, VSFmem-InnerFront.gbr, VSFmem-Mask_Back.gbs, VSFmem-Mask_Front.gts, VSFmem-PCB_Edges.gbr, VSFmem-SilkS_Back.gbo]
2012-09-01 add pull-up to ebi_wait signals
    [VSFmem-Back.gbl, VSFmem-Front.gtl, VSFmem-InnerBack.gbr, VSFmem-InnerFront.gbr, VSFmem-Mask_Back.gbs, VSFmem-Mask_Front.gts, VSFmem-PCB_Edges.gbr, VSFmem-SilkS_Back.gbo]
2012-09-01 VSFmem update for adjusting silks layer
    [VSFmem-Back.gbl, VSFmem-Front.gtl, VSFmem-InnerBack.gbr, VSFmem-InnerFront.gbr, VSFmem-Mask_Back.gbs, VSFmem-Mask_Front.gts, VSFmem-PCB_Edges.gbr, VSFmem-SilkS_Back.gbo]
2012-09-02 add block_read_en parameter to nand driver
2012-09-04 add interface_gpio_pin_t to define a single pin
2012-09-09 implement tickclk control on PC by timer.h
2012-09-11 add bsp for vsfmem board
    [VSFmem-Back.gbl, VSFmem-Front.gtl, VSFmem-InnerBack.gbr, VSFmem-InnerFront.gbr, VSFmem-Mask_Back.gbs, VSFmem-Mask_Front.gts, VSFmem-PCB_Edges.gbr, VSFmem-SilkS_Back.gbo]
2012-09-12 add full modem interface for VSF platform hardwares
    [VSFmem-Back.gbl, VSFmem-Front.gtl, VSFmem-InnerBack.gbr, VSFmem-InnerFront.gbr, VSFmem-Mask_Back.gbs, VSFmem-Mask_Front.gts, VSFmem-PCB_Edges.gbr, VSFmem-SilkS_Back.gbo]
2012-09-12 fix zone area of VSFmem extension board
    [VSFmem-Back.gbl, VSFmem-Front.gtl, VSFmem-InnerBack.gbr, VSFmem-InnerFront.gbr, VSFmem-Mask_Back.gbs, VSFmem-Mask_Front.gts, VSFmem-PCB_Edges.gbr, VSFmem-SilkS_Back.gbo]
2012-09-13 VSF hardware update, no need 2 connector
    [VSFmem-Back.gbl, VSFmem-Front.gtl, VSFmem-InnerBack.gbr, VSFmem-InnerFront.gbr, VSFmem-Mask_Back.gbs, VSFmem-Mask_Front.gts, VSFmem-PCB_Edges.gbr, VSFmem-SilkS_Back.gbo]
2012-09-13 vsf hardware update: add 6 cs for ebi and 6 wait signal
    [VSFmem-Back.gbl, VSFmem-Front.gtl, VSFmem-InnerBack.gbr, VSFmem-InnerFront.gbr, VSFmem-Mask_Back.gbs, VSFmem-Mask_Front.gts, VSFmem-PCB_Edges.gbr, VSFmem-SilkS_Back.gbo]
2012-09-13 add a 3to8 line decoder to enable 6 ebi_cs in all in VSFCore_STM32 board
    [VSFmem-Back.gbl, VSFmem-Front.gtl, VSFmem-InnerBack.gbr, VSFmem-InnerFront.gbr, VSFmem-Mask_Back.gbs, VSFmem-Mask_Front.gts, VSFmem-PCB_Edges.gbr, VSFmem-SilkS_Back.gbo]
2012-09-14 add a jumper to disable line decoder in VSFCore_STM32 board
    [vsf_core-Back.gbl, vsf_core-Front.gtl, vsf_core-InnerBack.gbr, vsf_core-InnerFront.gbr, vsf_core-Mask_Back.gbs, vsf_core-Mask_Front.gts, vsf_core-PCB_Edges.gbr, vsf_core-SilkS_Back.gbo]
2012-09-15 add eeprom in vsfmem board
    [VSFmem-Back.gbl, VSFmem-Front.gtl, VSFmem-InnerBack.gbr, VSFmem-InnerFront.gbr, VSFmem-Mask_Back.gbs, VSFmem-Mask_Front.gts, VSFmem-PCB_Edges.gbr, VSFmem-SilkS_Back.gbo]
2012-09-15 KiCAD library update
2012-09-20 add SCL and SDA comment on VSFmem extension board
    [VSFmem-Back.gbl, VSFmem-Front.gtl, VSFmem-InnerBack.gbr, VSFmem-InnerFront.gbr, VSFmem-Mask_Back.gbs, VSFmem-Mask_Front.gts, VSFmem-PCB_Edges.gbr, VSFmem-SilkS_Back.gbo]
2012-09-20 add a connector hardware for 20Pin JTAG
    [Connect-Back.gbl, Connect-Front.gtl, Connect-Mask_Back.gbs, Connect-Mask_Front.gts, Connect-PCB_Edges.gbr, Connect-SilkS_Back.gbo, Connect-SilkS_Front.gto, Connect-SoldP_Back.gbp]
2012-10-07 add IIC mark for Memory extension board
    [VSFmem-Back.gbl, VSFmem-Front.gtl, VSFmem-InnerBack.gbr, VSFmem-InnerFront.gbr, VSFmem-Mask_Back.gbs, VSFmem-Mask_Front.gts, VSFmem-PCB_Edges.gbr, VSFmem-SilkS_Back.gbo]
2012-11-01 fix bug in STM32_SPI driver when configured in slave mode
2012-11-02 reset spi when initialize in STM32_SPI.c
2012-11-02 enable SPI02_ENABLE in VSF_stm32_core board
2012-11-25 add support for STM32 XD flash
2012-12-30 fix STM32_SDIO driver for test purpose
2013-02-03 versaloon driver update, make usbtoxxx layer independent.
2013-02-12 flash driver update for stm32, avoid access not existing registers
2013-02-13 fixes for the latest FW for the VersaloonMiniRelease1
    [app_cfg.h]
2013-02-15 add tvcc.control and tvcc.voltage to VersaloonFS. You can simply run echo 1 > tvcc.control to open tvcc output
2013-02-16 fix offset of help information of evsprog
    [vsprog.c]
2013-02-19 BUG fixes in stm32l support, unlock sequence will cause bus-fault is executed more than once
2013-02-20 update stm32 flash loader to support STM32L15 series, configurable by STM32L1_USE_FLASHLOADER in cm_stm32l1.c
2013-03-01 fix bug in PowerExt.c, which will cause target voltage polling die
2013-03-03 prepare to add multi-slot support
2013-03-03 remove static variable in stm32 flash loader
2013-03-03 remove static structure in target.c to better support multi-slot
2013-03-03 rename short name of embedded-vsprog-config from 'E' to 'X'
    [vsprog.c]
2013-03-03 fix vsprog helper function to display '-X' instead of '-E'
    [vsprog.c]
2013-03-04 add slot 0 target directory for EVSPROG_EN
2013-03-17 project update for STM32F10X_XL
2013-03-19 fix a typo in versaloon.c
    [versaloon.c]
2013-03-19 check HW_HAS_LEDARRAY before call LED_ARRAY functions
2013-03-21 EBI driver update, un-initialize GPIO when call fini
2013-03-21 ProRelease2 hardware update
    [Versaloon-Component.gtl, Versaloon-Copper.gbl, Versaloon-GND_Layer.gbr, Versaloon-Mask_Back.gbs, Versaloon-Mask_Front.gts, Versaloon-PCB_Edges.gbr, Versaloon-SilkS_Back.gbo, Versaloon-SilkS_Front.gto]
2013-03-21 add ProRelease3 hardware
    [Versaloon-Component.gtl, Versaloon-Copper.gbl, Versaloon-InnerComponent.gbr, Versaloon-InnerCopper.gbr, Versaloon-Mask_Back.gbs, Versaloon-Mask_Front.gts, Versaloon-PCB_Edges.gbr, Versaloon-SilkS_Back.gbo]
2013-03-21 add stlink support in ARM GCC
2013-03-24 add STM32_EBI.c to MSCBoot ARMGCC
2013-03-24 Versaloon ProRelease2 tweak for hardware and firmware
    [Versaloon-Component.gtl, Versaloon-Copper.gbl, Versaloon-GND_Layer.gbr, Versaloon-Mask_Back.gbs, Versaloon-Mask_Front.gts, Versaloon-PCB_Edges.gbr, Versaloon-SilkS_Back.gbo, Versaloon-SilkS_Front.gto]
2013-03-26 move USB connect closer to the middle of the board
    [Versaloon-Component.gtl, Versaloon-Copper.gbl, Versaloon-GND_Layer.gbr, Versaloon-Mask_Back.gbs, Versaloon-Mask_Front.gts, Versaloon-PCB_Edges.gbr, Versaloon-SilkS_Back.gbo, Versaloon-SilkS_Front.gto]
2013-03-26 move Versaloon LOGO to a visiable place
    [Versaloon-Component.gtl, Versaloon-Copper.gbl, Versaloon-GND_Layer.gbr, Versaloon-Mask_Back.gbs, Versaloon-Mask_Front.gts, Versaloon-PCB_Edges.gbr, Versaloon-SilkS_Back.gbo, Versaloon-SilkS_Front.gto]
2013-04-01 fix a BUG when initialize versaloon with no hardware connected
    [versaloon.c]
2013-04-03 1. update for using the latest KiCAD 2. add a pull-up resistor on RST line of the LCD in ProRelease3 hardware
    [Versaloon-B_Mask.gbs, Versaloon-B_Paste.gbp, Versaloon-B_SilkS.gbo, Versaloon-Component.gtl, Versaloon-Copper.gbl, Versaloon-Edge_Cuts.gbr, Versaloon-F_Mask.gts, Versaloon-F_Paste.gtp]
2013-04-25 ProRelease3 hardware update for pullup on RESET line of screen
    [Versaloon-B_Mask.gbs, Versaloon-B_Paste.gbp, Versaloon-B_SilkS.gbo, Versaloon-Component.gtl, Versaloon-Copper.gbl, Versaloon-Edge_Cuts.gbr, Versaloon-F_Mask.gts, Versaloon-F_Paste.gtp]
2013-04-27 fix position of R41 in ProRelease3 hardware
    [Versaloon-B_Mask.gbs, Versaloon-B_Paste.gbp, Versaloon-B_SilkS.gbo, Versaloon-Component.gtl, Versaloon-Copper.gbl, Versaloon-Edge_Cuts.gbr, Versaloon-F_Mask.gts, Versaloon-F_Paste.gtp]
2013-05-01 stm32 interface driver update, do not use stm32_GPIO_INPD or stm32_GPIO_INPU in driver
2013-05-03 add -T to set target-specified parameter, fix cfi.c to use the target-specified parameter
    [vsprog.c]
2013-05-07 add UID support to interface, use UID as serial number for USB Device
2013-05-07 update VersaloonProRelease3 hardware, use A10 for CMD/DATA of LCD
    [Versaloon-B_Mask.gbs, Versaloon-B_Paste.gbp, Versaloon-B_SilkS.gbo, Versaloon-Component.gtl, Versaloon-Copper.gbl, Versaloon-Edge_Cuts.gbr, Versaloon-F_Mask.gts, Versaloon-F_Paste.gtp]
2013-05-07 update VersaloonProRelease3 hardware, add 4 jumpers for 20-PIN JTAG port
    [Versaloon-B_Mask.gbs, Versaloon-B_Paste.gbp, Versaloon-B_SilkS.gbo, Versaloon-Component.gtl, Versaloon-Copper.gbl, Versaloon-Edge_Cuts.gbr, Versaloon-F_Mask.gts, Versaloon-F_Paste.gtp]
2013-05-12 VersaloonProRelease3 hardware update, add RDY/BSY signal to EBI port
    [Versaloon-B_Mask.gbs, Versaloon-B_Paste.gbp, Versaloon-B_SilkS.gbo, Versaloon-Component.gtl, Versaloon-Copper.gbl, Versaloon-Edge_Cuts.gbr, Versaloon-F_Mask.gts, Versaloon-F_Paste.gtp]
2013-05-22 add PDF version of Schematics for VersaloonMiniRelease1
2013-06-10 Use NOR+PSRAM MCP for ProRelease3 hardware
    [Versaloon-B_Mask.gbs, Versaloon-B_Paste.gbp, Versaloon-B_SilkS.gbo, Versaloon-Component.gtl, Versaloon-Copper.gbl, Versaloon-Edge_Cuts.gbr, Versaloon-F_Mask.gts, Versaloon-F_Paste.gtp]
2013-06-10 kicad library update for MCP schematics
2013-06-13 fix different EBI_TGTTYP_NAND value between PC host and versaloon device
2013-06-24 update RPx4 module
    [Versaloon-B_Mask.gbs, Versaloon-B_Paste.gbp, Versaloon-B_SilkS.gbo, Versaloon-Component.gtl, Versaloon-Copper.gbl, Versaloon-Edge_Cuts.gbr, Versaloon-F_Mask.gts, Versaloon-F_Paste.gtp]
2013-06-28 add mux_addr_mask to ebi_common, used to select target chip by an ADDR pin.
2013-07-01 VersaloonPro Release3 update, add a connector for TVCC and TVREF
    [Versaloon-B_Mask.gbs, Versaloon-B_Paste.gbp, Versaloon-B_SilkS.gbo, Versaloon-Component.gtl, Versaloon-Copper.gbl, Versaloon-Edge_Cuts.gbr, Versaloon-F_Mask.gts, Versaloon-F_Paste.gtp]
2014-03-23 tweak STM32_FLASH.c
2014-03-25 add base_addr to cfi_drv_param_t to set the base address of the current cfi
2014-03-26 update evsprog for slot support
2014-03-27 use "programming slot" for the slot in vsprog, with which programming multiple targets at the same time can be supported
2014-04-01 fix a BUG in stm32f1_get_flash_size, which will take 1024K flash as 0
2014-04-02 add vsfui_fb frame_buffer driver and s6b0724 driver
2014-04-09 bug fix for frame buffer driver
2014-04-12 use mal for driver of frame buffer
2014-05-05 add get_max_value for ADC interface
2014-06-06 vsfusbd update(interfaces->usbd has no reference to vsfusbd now) and bug fix
    [interfaces.c, interfaces.h]
2014-06-10 add stm32_interface_set_stack in header file for stm32
2014-07-11 add joystick and key driver
2014-09-13 add NanoRelease2 hardware
    [Versaloon-B_Mask.gbs, Versaloon-B_Paste.gbp, Versaloon-B_SilkS.gbo, Versaloon-Component.gtl, Versaloon-Copper.gbl, Versaloon-Edge_Cuts.gbr, Versaloon-F_Mask.gts, Versaloon-F_Paste.gtp]
2014-10-06 add stm32f2_flash_unlock
2014-10-06 remove old driver for versaloon
2014-12-02 fix nuc400 support for fuse
2014-12-03 fix bug in comport driver for evsprog
2014-12-19 add ledarr support to Pro3 hardware
2015-01-17 bug fix: fail to assert default interface
    [interfaces.c]
2020-11-07 Fix Versaloon USB detection and linux device permissions
    [versaloon.c]
2020-11-07 Fix arm-gcc linker script, so that compilation does not fail
2020-11-07 Add STM32F103C8 Blue Pill, set it as the default board
2020-11-07 Fix interface naming not returning valid strings
    [app_interfaces.c, app_interfaces.h, interfaces.c, interfaces.h]
